Nathan6426/MCP201-STM32-Line-Follower/README.md

# STM32 Line Following Robot

**MCP201 — Microcontroller Programming**

STM32F103C8T6 · 5-Channel Infrared Tracking · DRV8833 · PWM Motor Control

A microcontroller-based autonomous robot designed to detect and follow a line using infrared sensors and differential motor control.

**Project Status:** Prototype developed — further testing and optimization required.

---

## Table of Contents

1. [Project Overview](#1-project-overview)
2. [System Architecture](#2-system-architecture)
3. [Hardware Design](#3-hardware-design)
4. [Firmware Implementation](#4-firmware-implementation)
5. [Repository Structure](#5-repository-structure)
6. [Setup and Reproduction](#6-setup-and-reproduction)
7. [Testing and Results](#7-testing-and-results)
8. [Technical Challenges and Limitations](#8-technical-challenges-and-limitations)
9. [Project Documentation](#9-project-documentation)
10. [Team Members](#10-team-members)
11. [Conclusion and Future Work](#11-conclusion-and-future-work)

---

## 1. Project Overview

### 1.1 Introduction

This project presents the design and implementation of an autonomous line-following robot based on the **STM32F103C8T6 (Blue Pill)** microcontroller.

The robot uses a five-channel TCRT5000 infrared sensor module to detect the position of a line on the ground. The microcontroller processes the sensor readings and controls two DC motors through a DRV8833 motor driver.

PWM signals generated by STM32 hardware timers are used for motor control.

### 1.2 Project Objectives

The primary objectives are:

- Interface digital infrared sensors with STM32 GPIO inputs.
- Configure hardware timers for PWM generation.
- Control two DC motors using the DRV8833 driver.
- Implement line-following decision logic.
- Integrate the hardware and firmware into a working prototype.
- Identify and evaluate practical limitations through testing.

### 1.3 Robot Prototype

The following photographs document the physical implementation of the robot.

**Front View**

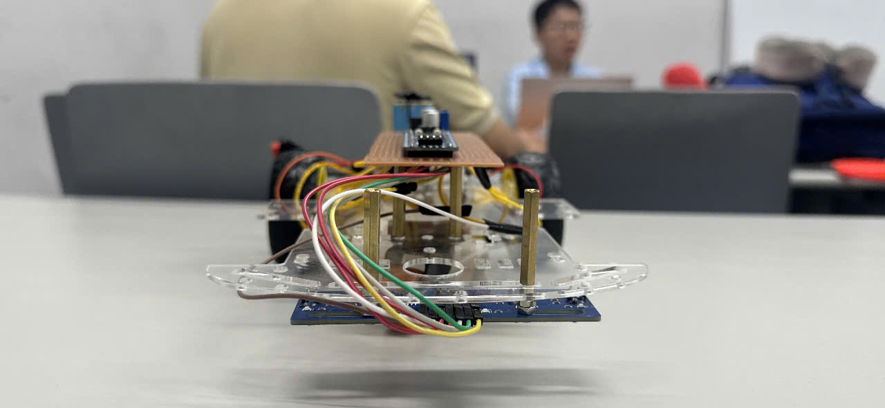
[picture p1: images/front.jpg]
Robot Front View


**Top View**

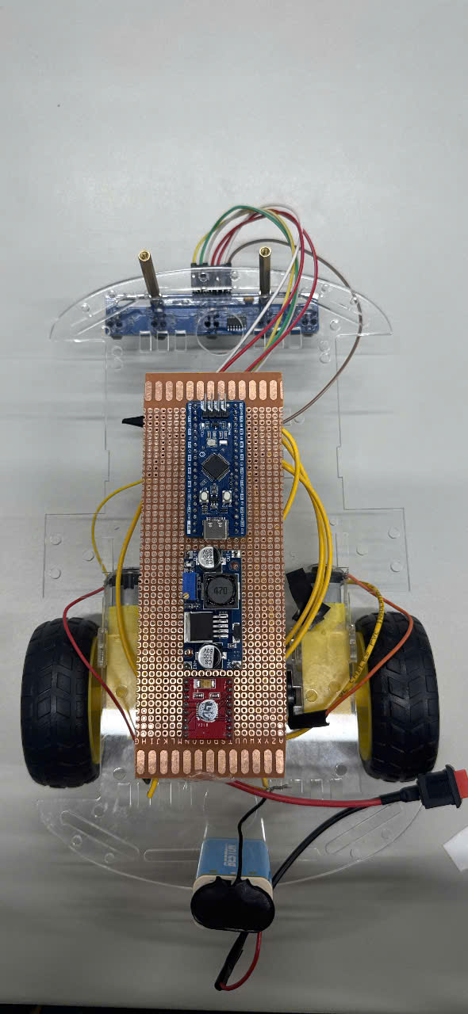
[picture p2: images/Top-Down.jpg]
Robot Top View


**Side View**

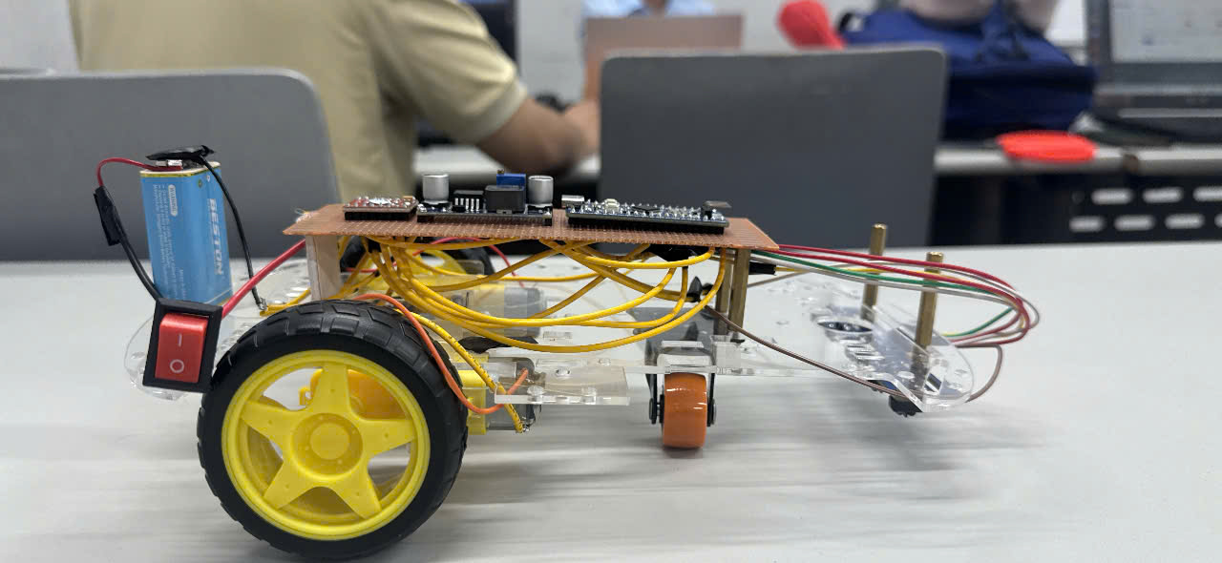
[picture p3: images/Side.jpg]
Robot Side View


**Rear View**

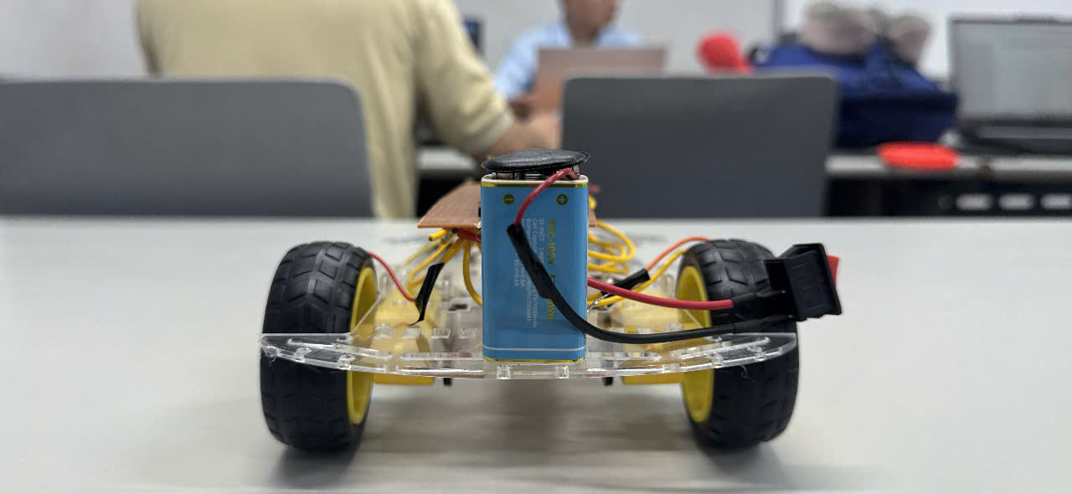
[picture p4: images/Rear.jpg]
Robot Rear View


Additional photographs are available in the [images directory](images/).

---

## 2. System Architecture

### 2.1 System Overview

The robot consists of four main functional blocks:

1. **Sensing:** The TCRT5000 infrared module detects the line.
2. **Processing:** The STM32F103C8T6 reads sensor signals and executes the control logic.
3. **Actuation:** The DRV8833 receives motor control signals and drives two DC motors.
4. **Power Management:** A 9 V battery supplies the system, while an LM2596 module provides regulated 5 V power.

### 2.2 Functional Block Diagram

```text
        +----------------------+
        |  TCRT5000 Sensor     |
        |  5 Digital Outputs   |
        +----------+-----------+
                   |
                   | PA0 - PA4
                   v
        +----------------------+
        | STM32F103C8T6       |
        | Blue Pill           |
        |                      |
        | GPIO + TIM3 + TIM4  |
        +----------+-----------+
                   |
                   | PWM Control
                   v
        +----------------------+
        | DRV8833 Motor Driver |
        +----------+-----------+
                   |
            +------+------+
            |             |
            v             v
       Left Motor     Right Motor
```

### 2.3 Power Distribution

The system uses the following power arrangement:

```text
        9 V Battery
             |
        Power Switch
             |
       +-----+------+
       |            |
       v            v
    DRV8833       LM2596
    Motor         DC-DC
    Supply        Converter
       |            |
       v            v
    DC Motors     5 V Output
                    |
              +-----+------+
              |            |
              v            v
           STM32         TCRT5000
           Blue Pill     Sensor Module
```

All system components share a common ground.

**Important:** Power supply stability must be checked under motor load. The sensor output voltage must also remain compatible with the STM32 GPIO input voltage limits.

---

## 3. Hardware Design

### 3.1 Hardware Components

| Component | Specification | Function |
|---|---|---|
| Microcontroller | STM32F103C8T6 Blue Pill | Main controller |
| Infrared Sensor | 5-channel TCRT5000 | Line detection |
| Motor Driver | DRV8833 | Motor driving and control |
| DC Motors | 2 × TT geared motors, 3–9 V | Robot movement |
| Voltage Regulator | LM2596 | 5 V power regulation |
| Battery | 9 V | Main power supply |
| Switch | Power switch | System power control |

### 3.2 STM32 Pin Configuration

**Infrared Sensor Connections**

| Sensor Output | STM32 Pin |
|---|---|
| OUT1 | PA0 |
| OUT2 | PA1 |
| OUT3 | PA2 |
| OUT4 | PA3 |
| OUT5 | PA4 |

**Motor Driver Connections**

| STM32 Pin | Timer Channel | DRV8833 Input |
|---|---|---|
| PB6 | TIM4_CH1 | AIN1 |
| PB7 | TIM4_CH2 | AIN2 |
| PB4 | TIM3_CH1 | BIN1 |
| PB5 | TIM3_CH2 | BIN2 |

The DRV8833 nSLEEP input is connected to the STM32 board's 3.3 V supply.

The motor driver outputs are connected to the left and right DC motors.

### 3.3 Circuit Diagram

The following image is included in the repository as a circuit-related reference.

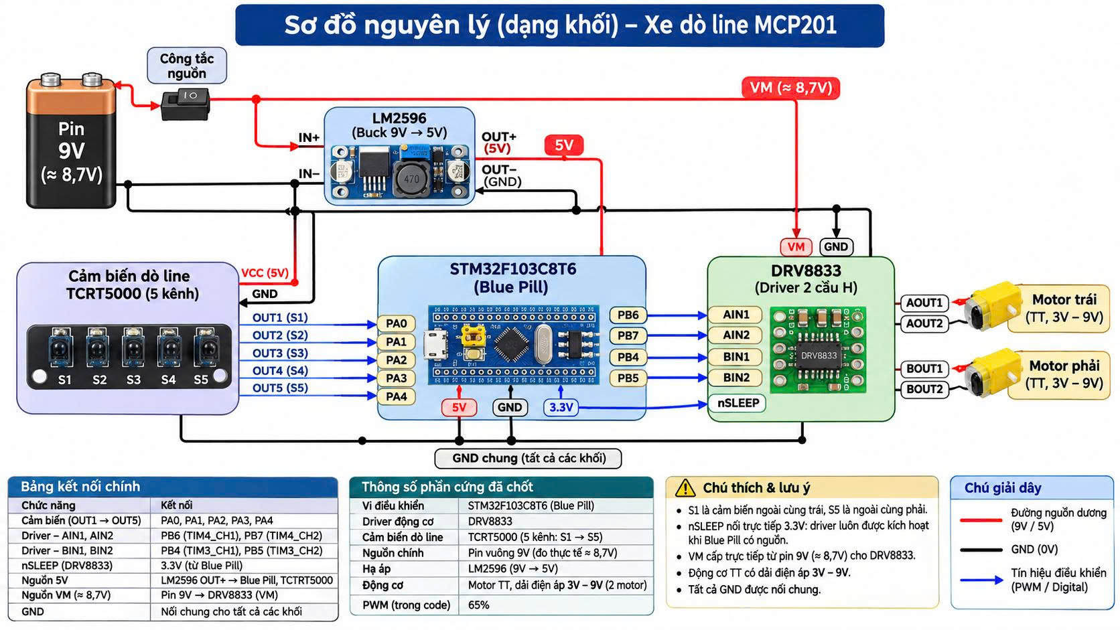
[picture p5: 1794224300982_4389226855427903812_4389226855427903812_1292c57cd401d00322f4e694686c0726.jpg]
Circuit Reference


**Documentation note:** The image content and its correspondence with the final physical wiring should be verified before it is treated as the validated circuit schematic.

---

## 4. Firmware Implementation

### 4.1 Development Environment

| Item | Description |
|---|---|
| IDE | STM32CubeIDE |
| Microcontroller | STM32F103C8T6 |
| Programming Language | C |
| Peripheral Configuration | STM32CubeMX / `.ioc` |
| Sensor Interface | GPIO |
| Motor Control | Timer-based PWM |

### 4.2 Sensor Reading

Five GPIO input pins are used to acquire digital signals from the infrared sensor array.

These signals indicate the sensor detection states and are processed to estimate the position of the line relative to the robot.

### 4.3 PWM Motor Control

The STM32 uses TIM3 and TIM4 to generate PWM control signals.

The DRV8833 motor driver receives these signals and controls the two motors.

By adjusting the motor outputs, the robot can modify its movement according to the detected line position.

### 4.4 Line-Following Algorithm

The general control sequence is:

1. Initialize the required STM32 peripherals.
2. Read the five infrared sensor inputs.
3. Evaluate the detected sensor pattern.
4. Determine the appropriate steering action.
5. Update the motor control outputs.
6. Repeat the process continuously.

The implementation details are available in [apps/main.c](apps/main.c).

The actual decision rules and motor output values should be taken from the firmware rather than inferred from this general description.

### 4.5 Source Files

| File | Description |
|---|---|
| [main.c](apps/main.c) | Application firmware |
| [main.h](main.h) | Application header |
| [doline1.ioc](doline1.ioc) | STM32 peripheral configuration |
| [doline1.zip](doline1.zip) | Archived STM32 project |
| [.project](.project) | Eclipse/STM32CubeIDE project metadata |
| [.cproject](.cproject) | C/C++ project configuration |

---

## 5. Repository Structure

The following structure reflects the current organization of the repository.

```text
MCP201-STM32-Line-Follower/
|
|-- README.md
|-- .gitignore
|-- .project
|-- .cproject
|
|-- main.h
|-- doline1.ioc
|-- doline1.zip
|
|-- apps/
|   |-- main.c
|   |-- app/
|
|-- images/
|   |-- front.jpg
|   |-- Rear.jpg
|   |-- Side.jpg
|   |-- Side_2.jpg
|   |-- Top-Down.jpg
|   |-- Down-Top.jpg
|   |-- lalala.c
|
|-- Docx/
|   |-- J4F_MCP201_BAO_CAO_CHINH_THUC.pdf
|   |-- Xe_Tự_Hành_Dò_Line_STM32.pptx
|
|-- J4F_MCP201_BAO_CAO_Draw.docx
|
|-- 1794224300982_4389226855427903812_
|   4389226855427903812_1292c57cd401d00322f4e694686c0726.jpg
```

The final JPG filename above is visually wrapped for readability; it represents one file in the repository root.

The `apps/app/` directory is present in the repository, but its internal contents are not documented here.

---

## 6. Setup and Reproduction

### 6.1 Prerequisites

- STM32CubeIDE
- STM32 Blue Pill development board
- Compatible STM32 programming/debugging interface
- Required robot hardware components
- Suitable power supply

### 6.2 Download the Project

Clone the repository:

```bash
git clone https://github.com/Nathan6426/MCP201-STM32-Line-Follower.git
```

Alternatively, download the repository ZIP from GitHub.

### 6.3 Import into STM32CubeIDE

1. Extract the `doline1.zip` project archive.
2. Open STM32CubeIDE.
3. Select the option to import an existing project.
4. Locate the extracted project directory.
5. Verify the selected microcontroller and peripheral configuration.
6. Check the source file locations and project settings.
7. Build the firmware.

### 6.4 Flash and Test

1. Connect the STM32 board to a compatible programmer/debugger.
2. Verify the electrical connections.
3. Check the regulated supply voltage.
4. Flash the firmware.
5. Position the robot on a suitable line-following track.
6. Observe the sensor and motor behavior.

**Reproducibility note:** A clean build and successful flashing procedure from a fresh repository clone have not yet been independently verified.

---

## 7. Testing and Results

### 7.1 Testing Objectives

The testing process focuses on:

- Sensor detection behavior.
- Motor control functionality.
- Basic line-following capability.
- Response to track curvature.
- Power supply stability.

### 7.2 Preliminary Observations

| Test Area | Observation |
|---|---|
| Basic line following | Successful on some simple track sections |
| Sharp turns | Reliable performance not yet established |
| Intersections | Remain challenging |
| Sensor stability | Unstable readings observed under certain conditions |
| Power supply | Voltage drops observed under motor load |

### 7.3 Testing Limitations

The current documentation does not provide a complete quantitative performance benchmark.

The following results have not yet been established through documented repeatable testing:

- Overall line-following success rate.
- Maximum reliable operating speed.
- Sharp-turn success rate.
- Intersection handling success rate.
- Long-duration operating reliability.

These measurements are recommended for future validation.

---

## 8. Technical Challenges and Limitations

### 8.1 Power Supply Stability

Voltage drops have been observed during motor operation.

A stable power supply is important for reliable microcontroller, sensor, and motor operation.

The 9 V battery and power distribution system require further evaluation under realistic load conditions.

### 8.2 Sensor Reliability

Infrared sensor performance depends on:

- Surface reflectivity.
- Sensor-to-ground distance.
- Sensor calibration.
- Ambient lighting conditions.
- Electrical noise and power stability.

Unstable sensor signals may cause incorrect steering decisions.

### 8.3 Track Complexity

The current prototype has not demonstrated reliable operation across all track conditions.

Sharp turns and intersections remain important areas for improvement.

### 8.4 Development and Verification

The repository provides source files and an archived project, but full build reproducibility has not yet been verified.

Further integration testing is required before claiming complete system reliability.

---

## 9. Project Documentation

The following files are available for additional project information.

| Document | Link |
|---|---|
| Final Project Report | [Download PDF](Docx/J4F_MCP201_BAO_CAO_CHINH_THUC.pdf) |
| Project Presentation | [View PPTX](Docx/Xe_Tự_Hành_Dò_Line_STM32.pptx) |
| Report Draft | [Download DOCX](J4F_MCP201_BAO_CAO_Draw.docx) |
| Firmware Source | [View main.c](apps/main.c) |
| Archived STM32 Project | [Download ZIP](doline1.zip) |
| Robot Photographs | [View Images](images/) |

---

## 10. Team Members

This project is developed collaboratively by four GitHub contributors.

| GitHub Account | Project Area |
|---|---|
| [Nathan6426](https://github.com/Nathan6426) | Firmware and STM32 project |
| [6626hieunguyen-tech](https://github.com/6626hieunguyen-tech) | Team contribution |
| [Andytvyt](https://github.com/Andytvyt) | Team contribution |
| [thientam615123](https://github.com/thientam615123) | Team contribution |

The final responsibility mapping should be updated to reflect each member's verified contributions.

Contribution history is available in the repository's GitHub commit history.

---

## 11. Conclusion and Future Work

### 11.1 Conclusion

This project demonstrates the practical integration of an STM32 microcontroller, infrared line-tracking sensors, hardware PWM generation, and DC motor control.

The prototype provides a foundation for studying embedded control systems and autonomous mobile robots.

Initial testing demonstrates basic line-following functionality, while several technical limitations remain.

### 11.2 Future Improvements

Recommended improvements include:

1. Improving power supply stability.
2. Calibrating the infrared sensors.
3. Improving steering decisions for sharp turns.
4. Developing more reliable intersection handling.
5. Performing repeatable performance tests.
6. Verifying the complete STM32CubeIDE build and flashing workflow.

---

**MCP201 — Microcontroller Programming**

**STM32 Line Following Robot Project**

[GitHub Repository](https://github.com/Nathan6426/MCP201-STM32-Line-Follower)
