Nathan6426/MCP201-STM32-Line-Follower/images/Down-Top.jpg

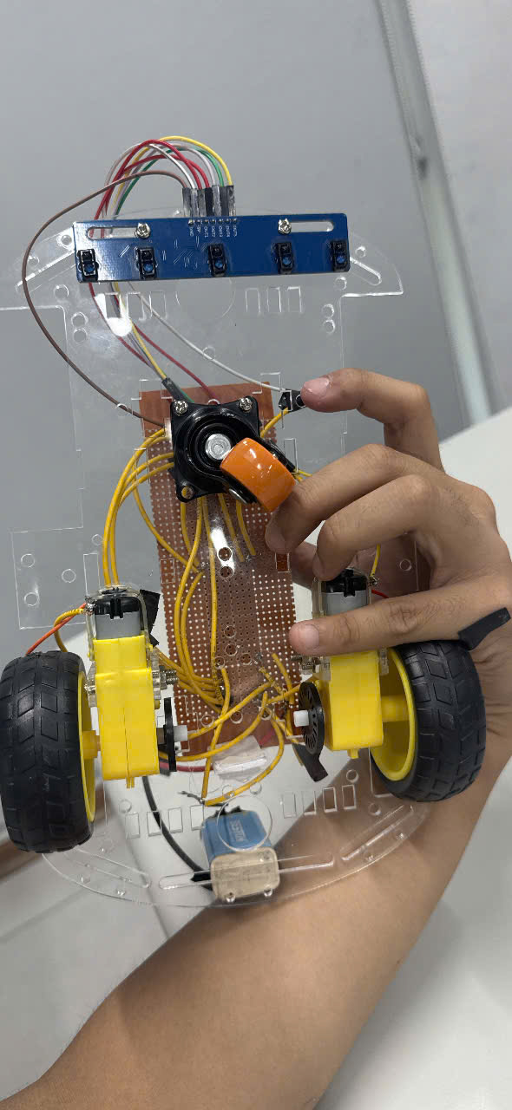
images/Down-Top.jpg
