Nathan6426/MCP201-STM32-Line-Follower/images/Side_2.jpg

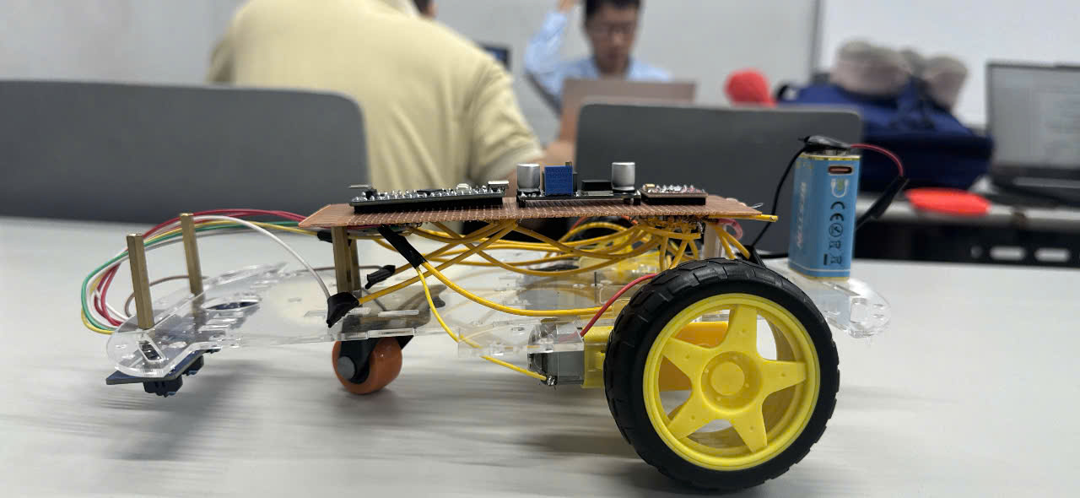
images/Side_2.jpg
