Nathan6426/MCP201-STM32-Line-Follower/doline1.ioc

Mcu.UserName=STM32F103C8Tx
PA0-WKUP.Signal=GPIO_Input
PA1.Signal=GPIO_Input
PA13.Signal=SYS_JTMS-SWDIO
PA14.Signal=SYS_JTCK-SWCLK
PA2.Signal=GPIO_Input
PA3.Signal=GPIO_Input
PA4.Signal=GPIO_Input
PB4.Signal=S_TIM3_CH1
PB5.Signal=S_TIM3_CH2
PB6.Signal=S_TIM4_CH1
PB7.Signal=S_TIM4_CH2
