Nathan6426/MCP201-STM32-Line-Follower/(commit log)

2026-11-10 Add STM32 line follower source code and full project
2026-11-10 Ảnh của xe
